knielsen/pcb_pov/(commit log)

2013-11-15 Initial commit of POV control board, not yet complete.
    Schematics is mostly done, components are assigned and placed.
    Critical routing (power+usb) done.
    Commit now before experimenting with freerouting.net autorouting.
    [tiva_pcb1.kicad_pcb, tiva_pcb1.sch]
2013-11-15 Tweak a couple of things, in preparation for another autoroute attempt:
    - Fix position of the connectors around the edge of the board.
    - Proper ground plane zone fill.
    - Move USB data lines a bit to make more routing space.
    - Re-route the +3.3V along the top of the board to make more space for
    routing below where there are more signals.
    [tiva_pcb1.kicad_pcb]
2013-12-07 First complete version.
    Everything routed, DRC passes. Silk screen done, gerbers checked briefly.
    [tiva_pcb1-B_Cu.gbl, tiva_pcb1-B_Mask.gbs, tiva_pcb1-B_SilkS.gbo, tiva_pcb1-F_Cu.gtl, tiva_pcb1-F_Mask.gts, tiva_pcb1-F_SilkS.gto, tiva_pcb1-Inner1_Cu.gbr, tiva_pcb1-Inner2_Cu.gbr]
2013-12-08 Final gerbers for rev1 manufature
    [tiva_pcb1-B_Cu.gbl, tiva_pcb1-B_Mask.gbs, tiva_pcb1-B_SilkS.gbo, tiva_pcb1-F_Cu.gtl, tiva_pcb1-F_Mask.gts, tiva_pcb1-F_SilkS.gto]
